dariusur/BlueTachometer/misc/graphs/PC_cooling_fan.png

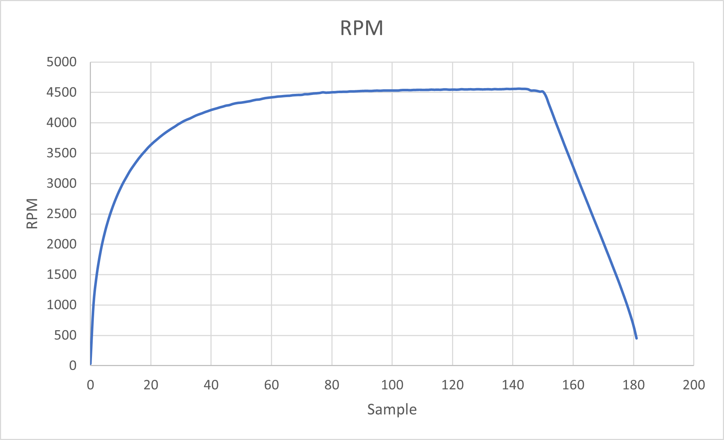
misc/graphs/PC_cooling_fan.png
