dariusur/BlueTachometer/misc/graphs/resolution_graph.png

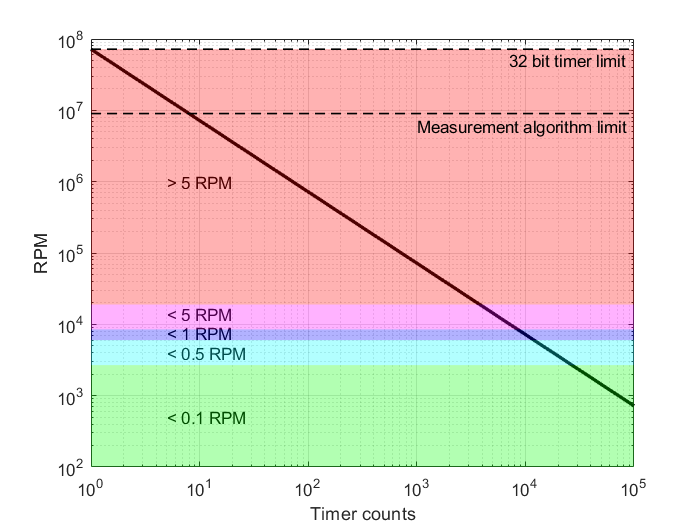
misc/graphs/resolution_graph.png
